Frazix12/SMD-Rework-Station/Manufacture/Bottom_Silk_Layer.pdf

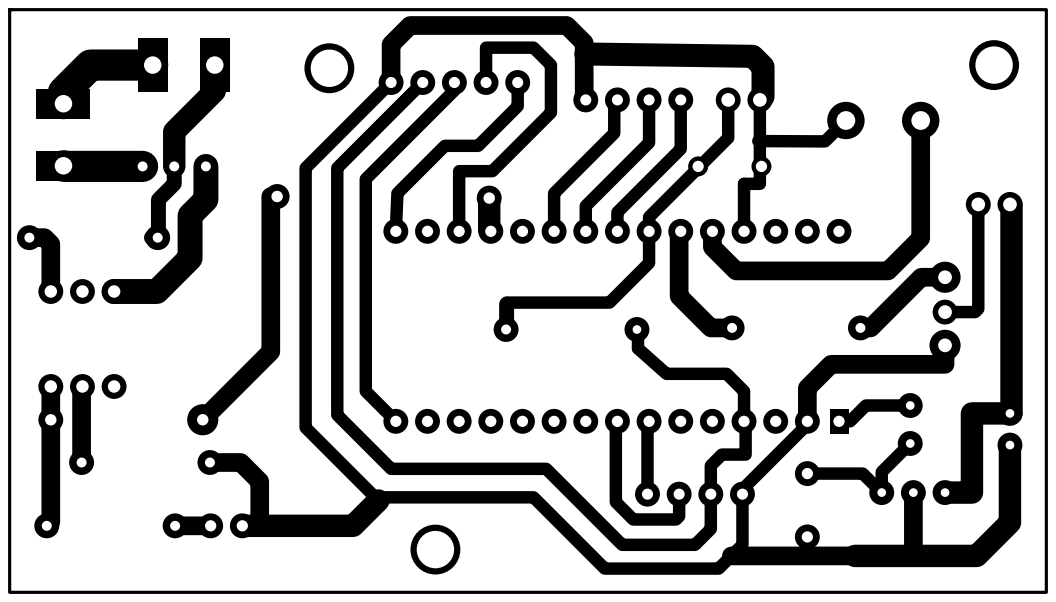
[picture p6: page 1]
