Frazix12/SMD-Rework-Station/Manufacture/Top_Silk_Layer.pdf

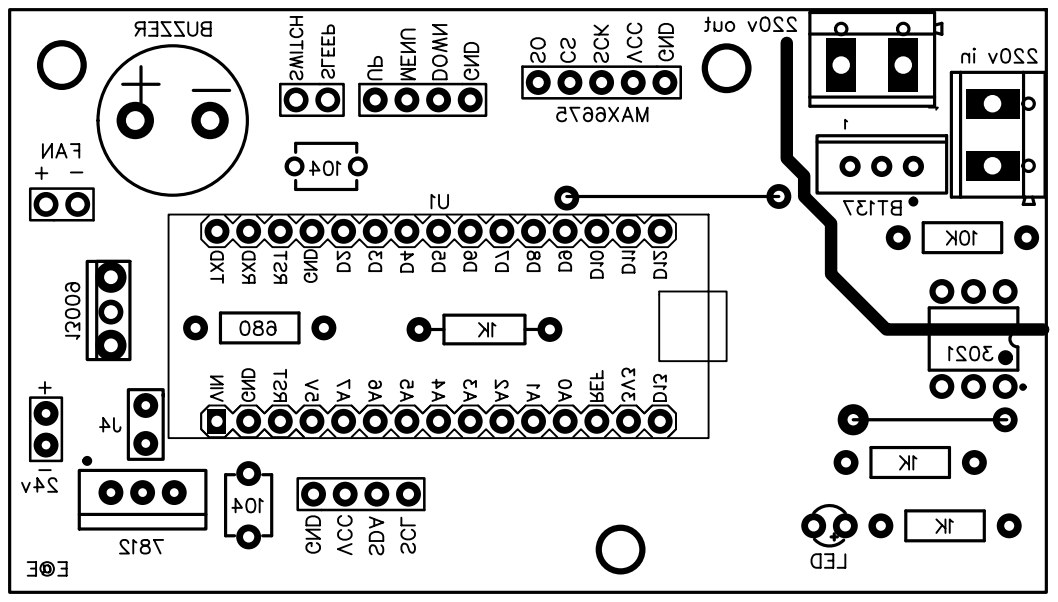
[picture p7: page 1]
