Frazix12/SMD-Rework-Station/Manufacture/Button/Button_Bottom_Silk_Layer.pdf

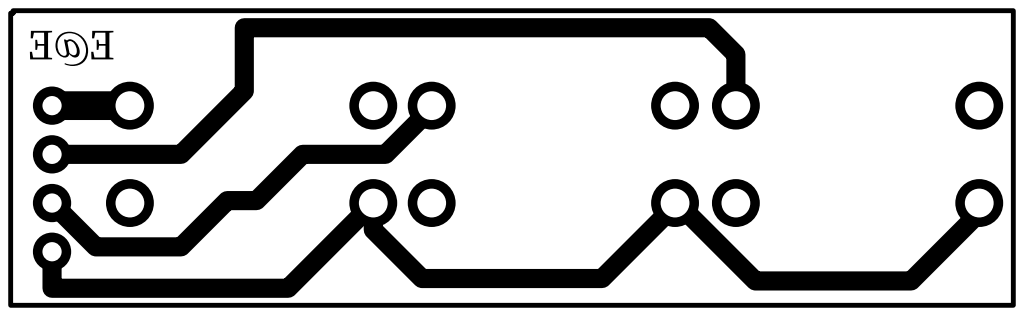
[picture p8: page 1]
