Frazix12/SMD-Rework-Station/Manufacture/Button/Button_Top_Silk_Layer.pdf

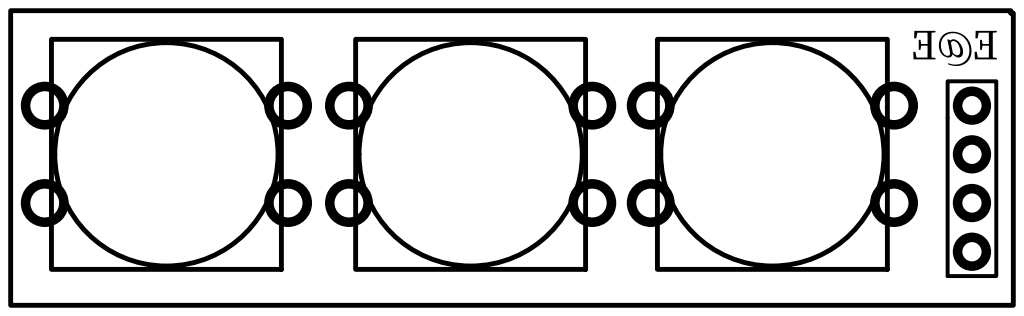
[picture p9: page 1]
